jwjung0/esp-smartClock/src/board_check.cpp

#include "board_check.h"

#if defined(FIRMWARE_MODE_CHECKUP)

#include "bl_ctrl.h"
#include "bme_sensor.h"
#include "board_pins.h"
#include "light_sensor.h"
#include "weather_fetch.h"

#include <Adafruit_GFX.h>
#include <Adafruit_ST7789.h>
#include <Arduino.h>
#include <Preferences.h>
#include <SPI.h>
#include <WiFi.h>

static const int LED_PIN = BOARD_LED_PIN;
static const unsigned long STEP_MS = 1200;
static const uint16_t kScreenW = 240;
static const uint16_t kScreenH = 240;
static const uint32_t kSpiHz = 8000000;

static Adafruit_ST7789 tft =
    Adafruit_ST7789(&SPI, PIN_TFT_CS, PIN_TFT_DC, PIN_TFT_RST);

static const uint16_t kColors[] = {ST77XX_RED,   ST77XX_GREEN,  ST77XX_BLUE,
                                   ST77XX_WHITE, ST77XX_YELLOW, ST77XX_CYAN,
                                   ST77XX_BLACK};
static const char *kColorNames[] = {"RED",    "GREEN", "BLUE", "WHITE",
                                    "YELLOW", "CYAN",  "BLACK"};
static const size_t kColorCount = sizeof(kColors) / sizeof(kColors[0]);
static size_t colorIndex = 0;
static bool lcdReady = false;

static void printLcdPins() {
  Serial.println("LCD expected wiring (SPI — panel SDA=MOSI, SCL=SCLK):");
  Serial.printf("  VCC=3V3  GND=GND\n");
  Serial.printf("  MOSI/SDA=%d  SCLK/SCL=%d  CS=%d  DC=%d  RST=%d  BL=%d\n",
                PIN_TFT_MOSI, PIN_TFT_SCLK, PIN_TFT_CS, PIN_TFT_DC, PIN_TFT_RST,
                PIN_TFT_BL);
}

static void printBmePins() {
  Serial.println("BMx280 expected wiring (I2C):");
  Serial.printf("  VCC=3V3  GND=GND  SDA=%d  SCL=%d\n", PIN_BME_SDA,
                PIN_BME_SCL);
  Serial.println("  CSB/SDO: leave board default (usually unconnected)");
}

static void printVemlPins() {
  Serial.println("VEML7700 expected wiring (I2C):");
  Serial.printf("  VCC=3V3  GND=GND  SDA=%d  SCL=%d  addr=0x10\n", PIN_VEML_SDA,
                PIN_VEML_SCL);
  Serial.println("  shared with climate I2C bus");
}

static void bmeCheckOnce() {
  if (!bmeSensorOk()) {
    Serial.println("BMx280 not ready — check VCC/GND/SDA/SCL only");
    return;
  }
  bmeSensorPrint();
}

static void lightCheckOnce() {
  if (!lightSensorOk()) {
    Serial.println("VEML7700 not ready — check VCC/GND/SDA/SCL");
    return;
  }
  lightSensorPrint();
  // After LCD/BL PWM is up, drive brightness from lux (same curve as app).
  if (lcdReady) {
    blCtrlUpdateFromLux();
    Serial.printf("BL duty=%d/255  ema=%.0f  auto=%s\n", blCtrlDuty(),
                  blCtrlLuxEma(), blCtrlAutoEnabled() ? "on" : "off");
  }
}

// Use NVS credentials saved by the app SoftAP portal (namespace wifi).
static bool wifiConnectFromNvs(uint32_t timeoutMs) {
  Preferences prefs;
  if (!prefs.begin("wifi", true)) {
    Serial.println(
        "OpenWeather: NVS wifi ns missing — flash app + provision first");
    return false;
  }
  const String ssid = prefs.getString("ssid", "");
  const String pass = prefs.getString("pass", "");
  prefs.end();

  if (ssid.isEmpty()) {
    Serial.println("OpenWeather: no saved SSID — run app portal once");
    return false;
  }

  Serial.printf("OpenWeather: WiFi STA → %s …\n", ssid.c_str());
  WiFi.mode(WIFI_STA);
  WiFi.begin(ssid.c_str(), pass.c_str());
  const uint32_t t0 = millis();
  while (WiFi.status() != WL_CONNECTED && (millis() - t0) < timeoutMs) {
    delay(250);
    Serial.print('.');
  }
  Serial.println();
  if (WiFi.status() != WL_CONNECTED) {
    Serial.println("OpenWeather: WiFi join FAIL");
    return false;
  }
  Serial.printf("OpenWeather: WiFi OK  IP=%s\n",
                WiFi.localIP().toString().c_str());
  return true;
}

static void lcdShowWeather(bool ok, float tC, float rh, const char *main) {
  if (!lcdReady)
    return;
  tft.fillScreen(ST77XX_BLACK);
  tft.setTextColor(ST77XX_WHITE);
  tft.setTextSize(2);
  tft.setCursor(8, 40);
  if (!ok) {
    tft.print("OW FAIL");
    tft.setCursor(8, 80);
    tft.print("see Serial");
    return;
  }
  tft.print("Weather");
  tft.setCursor(8, 80);
  tft.printf("T %.1f C", tC);
  tft.setCursor(8, 110);
  if (isnan(rh))
    tft.print("RH --");
  else
    tft.printf("RH %.0f %%", rh);
  tft.setCursor(8, 140);
  tft.printf("%s", main && main[0] ? main : "?");
  tft.drawRect(0, 0, kScreenW, kScreenH, ST77XX_CYAN);
}

static void openWeatherCheckOnce() {
  Serial.println();
  Serial.println("Weather probe (Naver KMA + OpenWeather)…");
  weatherFetchBegin();
  if (!wifiConnectFromNvs(20000)) {
    lcdShowWeather(false, 0, 0, nullptr);
    Serial.println("Weather test FAIL — WiFi");
    return;
  }
  const bool ok = weatherFetchOnce();
  float t = 0, h = 0;
  char mainBuf[16] = "";
  if (ok)
    weatherFetchGet(&t, &h, mainBuf, sizeof(mainBuf));
  lcdShowWeather(ok, t, h, mainBuf);
  if (ok)
    Serial.println("Weather test OK — see LCD + Serial line above");
  else
    Serial.println("Weather test FAIL — check weather_config.h");
  WiFi.disconnect(true);
  WiFi.mode(WIFI_OFF);
  Serial.println("Weather: WiFi off");
  Serial.println();
}

static void blinkBacklight() {
  Serial.println("BL blink test — backlight should pulse 6 times (PWM)");
  blCtrlBegin();
  for (int i = 0; i < 6; i++) {
    blCtrlSetOn(false);
    Serial.printf("  BL OFF %d/6\n", i + 1);
    delay(350);
    blCtrlSetOn(true);
    Serial.printf("  BL ON  %d/6\n", i + 1);
    delay(350);
  }
  blCtrlSetOn(true);
  Serial.println(
      "If BL did not blink, move LCD BL wire to GPIO22 (D22), not 3V3");
}

static void lcdShowColor(size_t idx) {
  if (!lcdReady)
    return;
  const uint16_t color = kColors[idx];
  const char *name = kColorNames[idx];
  const uint16_t text = (color == ST77XX_BLACK || color == ST77XX_BLUE)
                            ? ST77XX_WHITE
                            : ST77XX_BLACK;

  tft.fillScreen(color);
  tft.setTextColor(text);
  tft.setTextSize(3);
  tft.setCursor(40, 100);
  tft.print(name);
  tft.drawRect(0, 0, kScreenW, kScreenH, ST77XX_WHITE);
  Serial.printf("LCD fill %s\n", name);
}

static bool lcdBegin() {
  Serial.println("LCD init (Adafruit ST7789 @ 8 MHz, invert on)...");
  SPI.begin(PIN_TFT_SCLK, -1 /* MISO */, PIN_TFT_MOSI, PIN_TFT_CS);
  tft.init(kScreenW, kScreenH);
  tft.setSPISpeed(kSpiHz);
  tft.setRotation(3); // 270° CW / 90° CCW
  tft.invertDisplay(true);
  blCtrlSetOn(true);
  lcdShowColor(0);
  Serial.println("LCD init done — expect color names on glass every ~1.2s");
  return true;
}

void boardCheckSetup() {
  pinMode(LED_PIN, OUTPUT);
  Serial.begin(115200);
  delay(1000);
  Serial.println();
  Serial.printf("smartClock board check OK (LED GPIO %d)\n", LED_PIN);

  // Probe I2C before LCD SPI so the bus scan is clean.
  Serial.println();
  printBmePins();
  Serial.println("BMx280 probe...");
  if (bmeSensorBegin()) {
    Serial.println("BMx280 test OK — expect readings every ~1.2s");
    bmeCheckOnce();
  } else {
    Serial.println("BMx280 test FAIL — see I2C scan above");
  }

  Serial.println();
  printVemlPins();
  Serial.println("VEML7700 probe...");
  if (lightSensorBegin()) {
    Serial.println("VEML7700 test OK — expect lux every ~1.2s");
    lightCheckOnce();
  } else {
    Serial.println("VEML7700 test FAIL — see wiring / I2C scan");
  }

  Serial.println();
  printLcdPins();
  blinkBacklight();
  lcdReady = lcdBegin();
  // Lux already probed — drive BL from ambient for the rest of checkup.
  blCtrlSetOn(true);
  blCtrlUpdateFromLux();
  Serial.printf("BL auto from lux  duty=%d/255\n", blCtrlDuty());

  // After LCD is up so pass/fail can paint on glass.
  openWeatherCheckOnce();
  // Hold weather screen briefly before color cycle resumes.
  delay(4000);
  Serial.println();
}

void boardCheckLoop() {
  digitalWrite(LED_PIN, HIGH);
  Serial.printf("LED ON, uptime=%lu ms\n", millis());

  colorIndex = (colorIndex + 1) % kColorCount;
  lcdShowColor(colorIndex);
  bmeCheckOnce();
  lightCheckOnce();
  delay(STEP_MS);

  digitalWrite(LED_PIN, LOW);
  Serial.printf("LED OFF, uptime=%lu ms\n", millis());
  delay(STEP_MS / 2);
}

#else

void boardCheckSetup() {}
void boardCheckLoop() {}

#endif
