jwjung0/esp-smartClock/include/tft_setup.h

// TFT_eSPI board setup (picked up via #include <tft_setup.h>).
// Pins come from board_pins_*.h via the active PlatformIO env.
#pragma once

#include "board_pins.h"

#if defined(BOARD_S2_MINI)
#define USER_SETUP_INFO "esp-smartClock-s2-mini"
#elif defined(BOARD_ESP32DEV)
#define USER_SETUP_INFO "esp-smartClock-esp32dev"
#endif

// No touch panel — silence TFT_eSPI TOUCH_CS warning.
#define DISABLE_ALL_LIBRARY_WARNINGS

#define ST7789_DRIVER
#define TFT_WIDTH  240
#define TFT_HEIGHT 240

#define TFT_MOSI PIN_TFT_MOSI
#define TFT_SCLK PIN_TFT_SCLK
#define TFT_CS   PIN_TFT_CS
#define TFT_DC   PIN_TFT_DC
#define TFT_RST  PIN_TFT_RST
// Do NOT define TFT_BL here — TFT_eSPI ST7789 init forces BL HIGH mid-init
// (white flash). App owns PIN_TFT_BL and enables it only after a black frame.
#define TFT_MISO -1

// Many 1.54" IPS ST7789 panels need inversion to show a normal image.
#define TFT_INVERSION_ON

#define LOAD_GLCD
// 10 MHz is more reliable on Dupont jumpers than 40 MHz.
#define SPI_FREQUENCY  10000000
#define SPI_READ_FREQUENCY  6000000
