jwjung0/esp-smartClock/include/ingest_config_local.h

#pragma once

// Local Mac LAN (mcp-home-assist on this machine).
static const char *INGEST_URL =
    "http://192.168.45.106:8110/api/climate/ingest";
static const char *DEVICE_ID = "smartclock01";
static const char *DEVICE_INGEST_TOKEN =
    "vwObvijjOhGTtXt+LlUA6Pulgs1gkRhsZbfEuzfncb0=";
