jwjung0/esp-smartClock/include/ingest_config_prod.h

#pragma once

// Prod Ubuntu LAN host — fill before flashing prod.
static const char *INGEST_URL = "http://192.168.x.x:8110/api/climate/ingest";
static const char *DEVICE_ID = "smartclock01";
static const char *DEVICE_INGEST_TOKEN = "vwObvijjOhGTtXt+LlUA6Pulgs1gkRhsZbfEuzfncb0=";
