jwjung0/esp-smartClock/src/loading_gif.h

#pragma once

#include <stddef.h>
#include <stdint.h>

#ifdef __cplusplus
extern "C" {
#endif

extern const uint8_t loading_gif_data[138804];
enum { kLoadingGifSize = 138804 };

#ifdef __cplusplus
}
#endif
