jwjung0/esp-smartClock/(commit log)

2026-10-26 Initial public release: ESP32 smart clock with WiFi portal and NTP.
2026-10-30 Adjust home screen temperature icon position
2026-10-30 style: current weather box color and radius to 4
2026-11-01 fix: screen freeze issue. keep clock UI free of Wi‑Fi and market HTTPS stalls
2026-11-04 fea: add light sensor (VEML7700) to control BL brightness
2026-11-04 Cut idle power: 80 MHz / 1 Hz UI idle, steeper BL curve, VEML auto-dim
2026-11-04 feat: add naver weather (default) and switchable in config
2026-11-04 ambient light and climate i2c share pincs on esp32
2026-11-10 feat: add new chart screen and will be switched by touch sensor later
2026-11-11 (wip) feat: new app for golf putting with ir sensors
2026-11-13 add touch switch TTF227 to switch screens
2026-11-13 add BOM
